ole00/27cf840_prog/design/27cf840_prog_r04.pdf

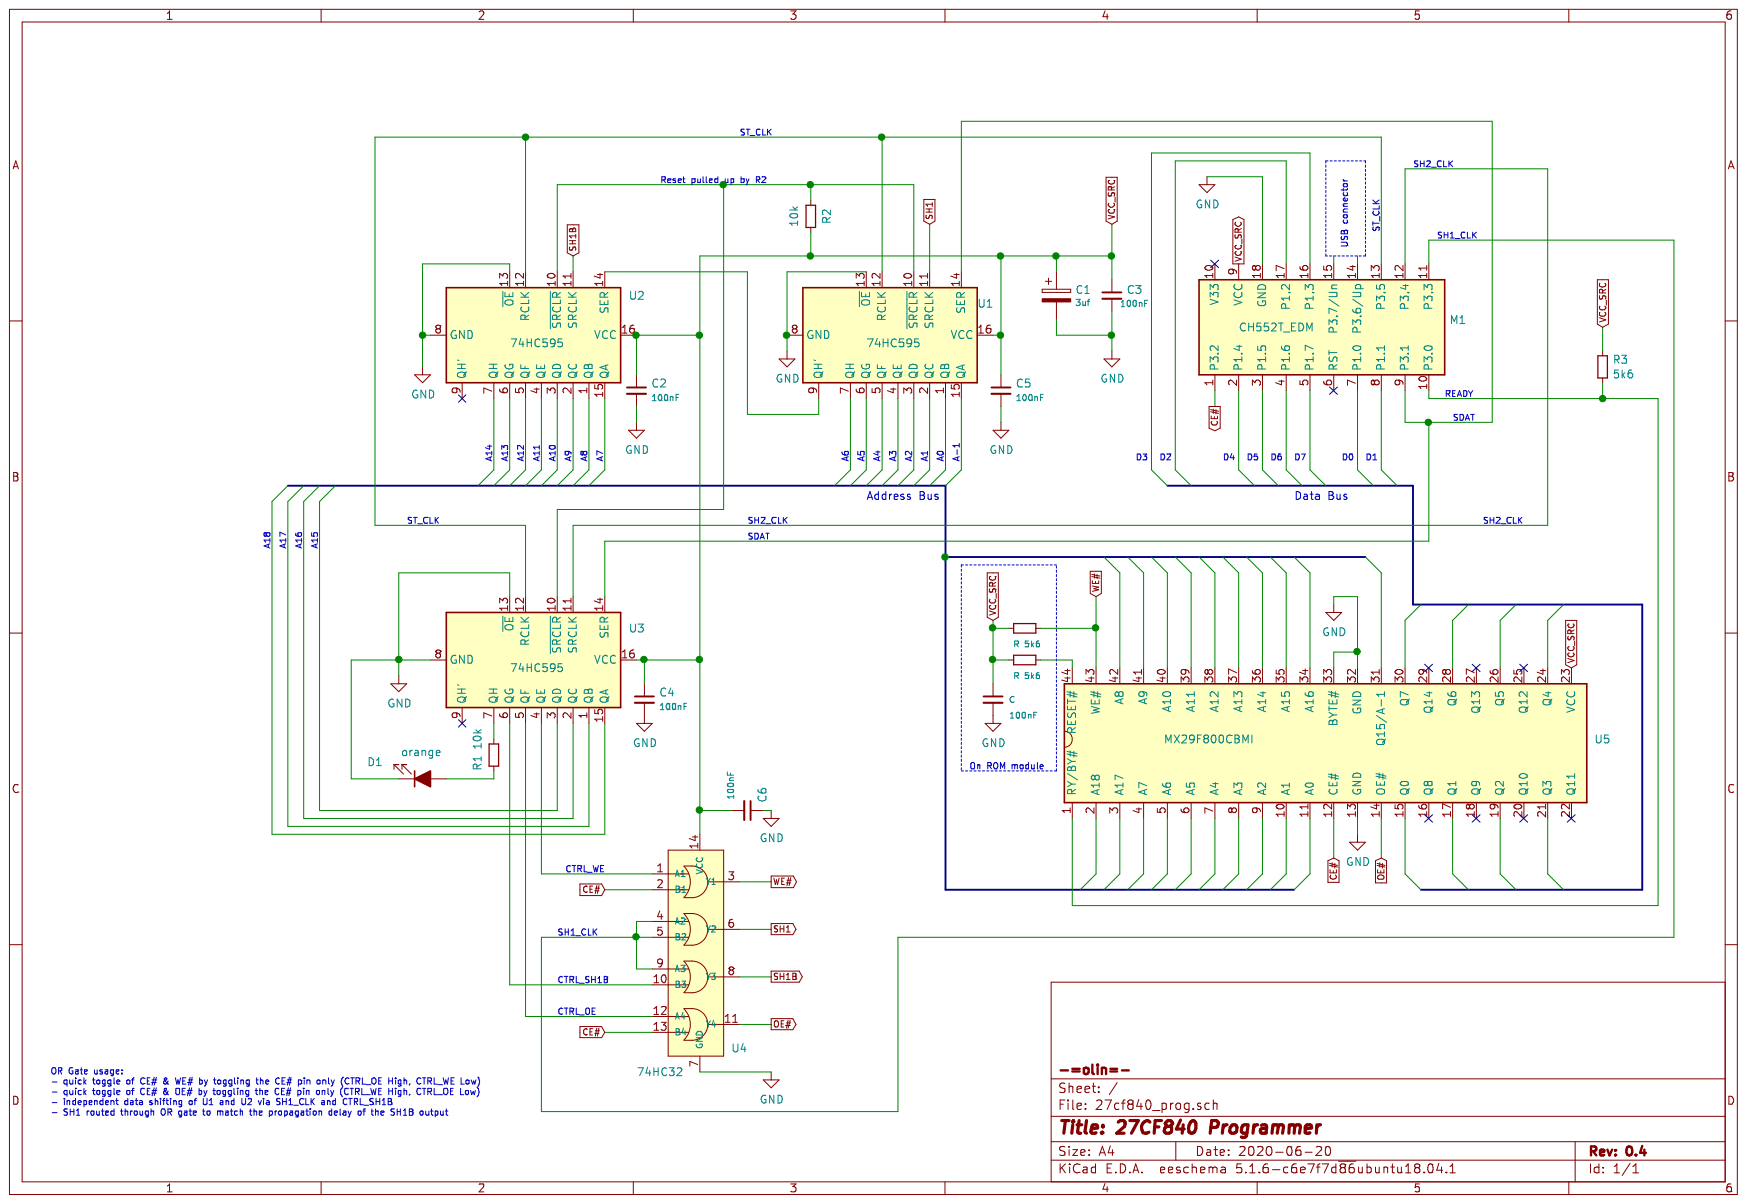
[picture p4: page 1]
