ole00/27cf840_prog/(list of files, drawings)

Other design files:
design/27c800a_rep.pcb
design/27c800b_rep.pcb
design/prog.pcb
