ole00/27cf840_prog/design/27cf840_prog_r04.sch

## KiCad design design/27cf840_prog_r04.sch (2020-07-18)

Schematic: 27cf840_prog_r04.sch

Parts:
C, C2, C3, C4, C5, C6: 100nF
C1: 3uf
D1: orange
M1: CH552T_EDM
R, R3: 5k6
R1, R2: 10k
U1, U2, U3: 74HC595
U4: 74HC32
U5: MX29F800CBMI

Notes on the sheet:
Data Bus
Address Bus
A18
A17
A16
A15
A14
A13
A12
A11
A-1
A10
CTRL_SH1B
CTRL_OE
CTRL_WE
SDAT
SH2_CLK
Reset pulled up by R2
ST_CLK
SH1_CLK
OR Gate usage: - quick toggle of CE# & WE# by toggling the CE# pin only (CTRL_OE High, CTRL_WE Low) - quick toggle of CE# & OE# by toggling the CE# pin only (CTRL_WE High, CTRL_OE Low) - independent data shifting of U1 and U2 via SH1_CLK and CTRL_SH1B - SH1 routed through OR gate to match the propa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
READY
On ROM module
USB connector
